mulempyo/ros_robot/gmapping rqt_graph.png

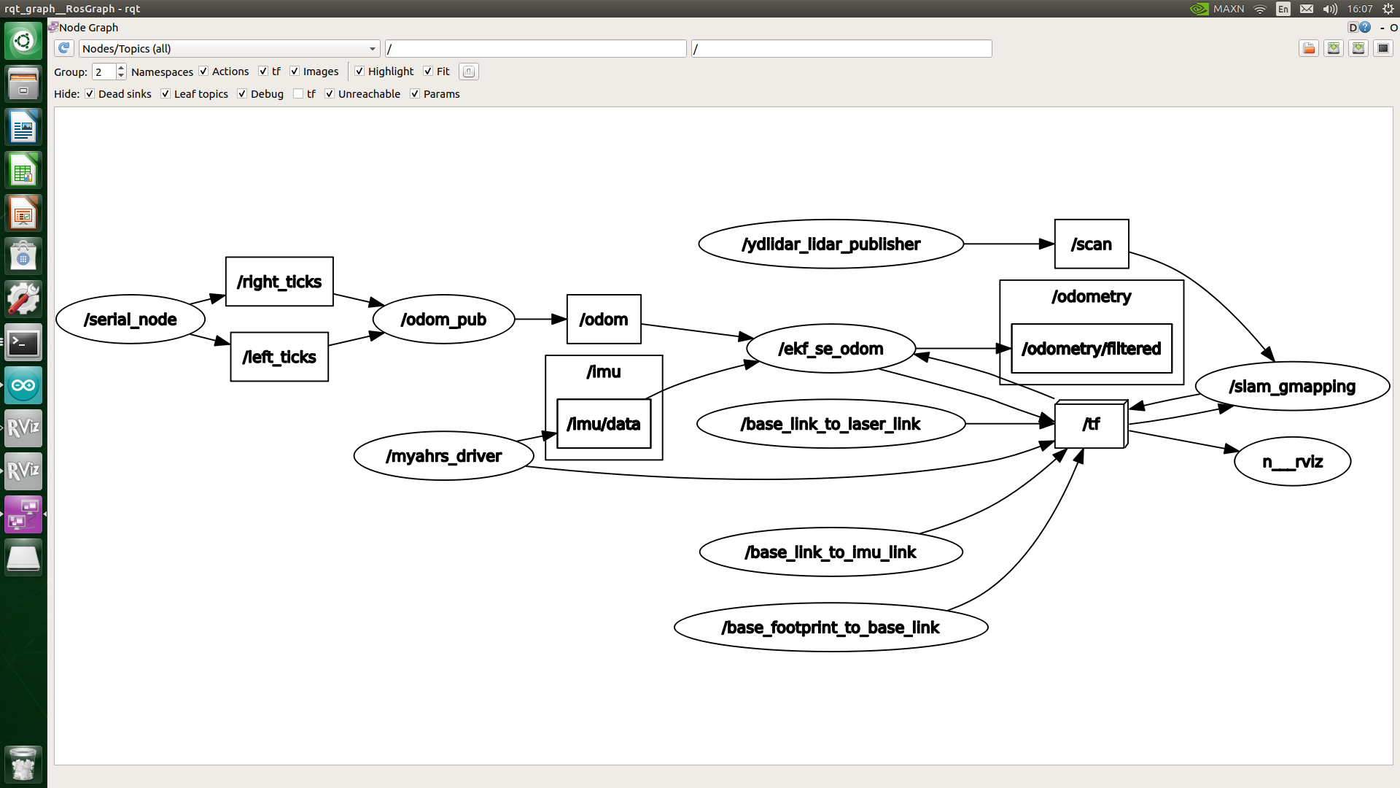
gmapping rqt_graph.png
