mulempyo/ros_robot/gmapping TF.png

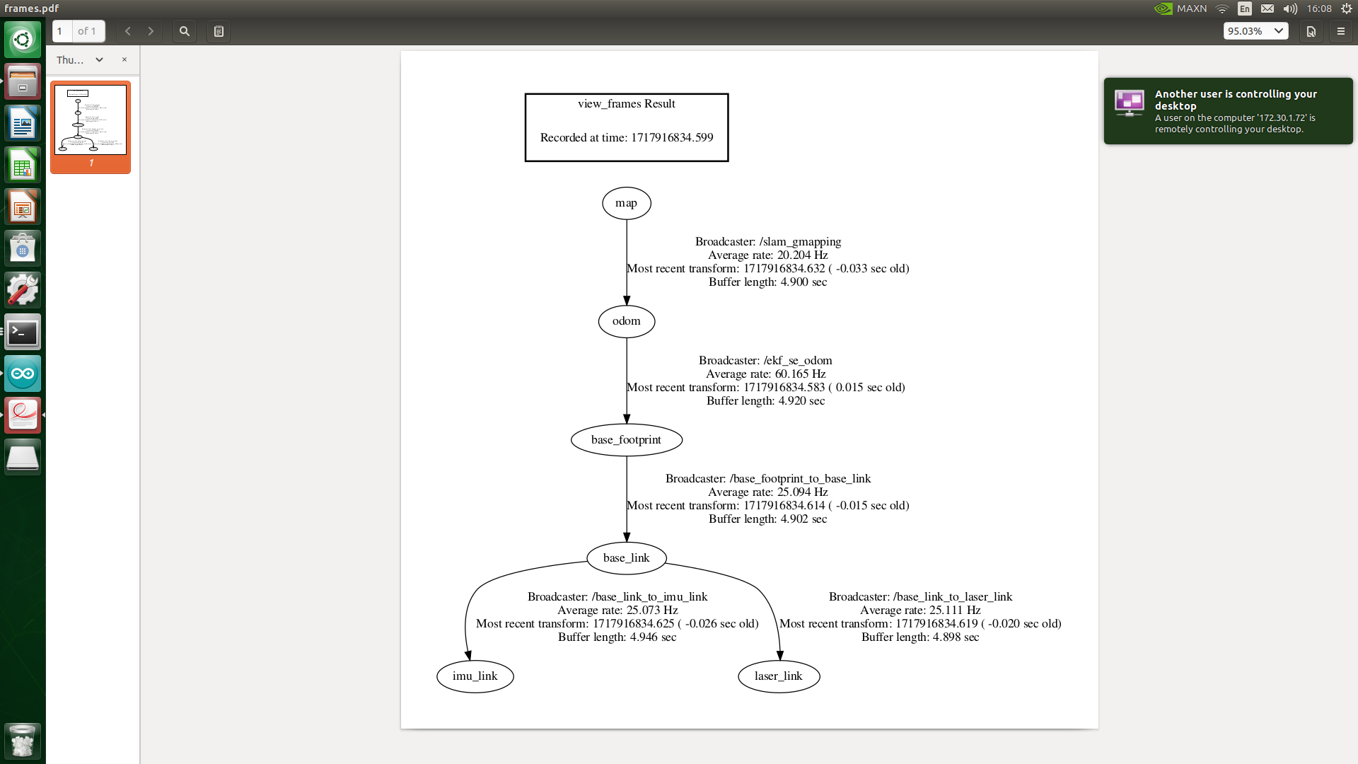
gmapping TF.png
