mulempyo/ros_robot/kwj_description/map/map.png

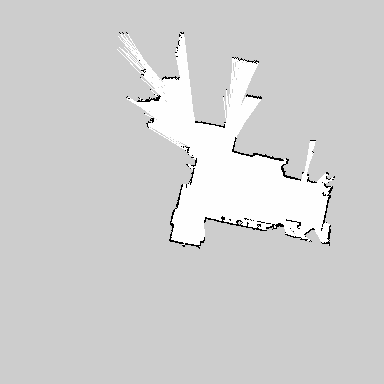
kwj_description/map/map.png
