mulempyo/ros_robot/Navi rqt_graph.png

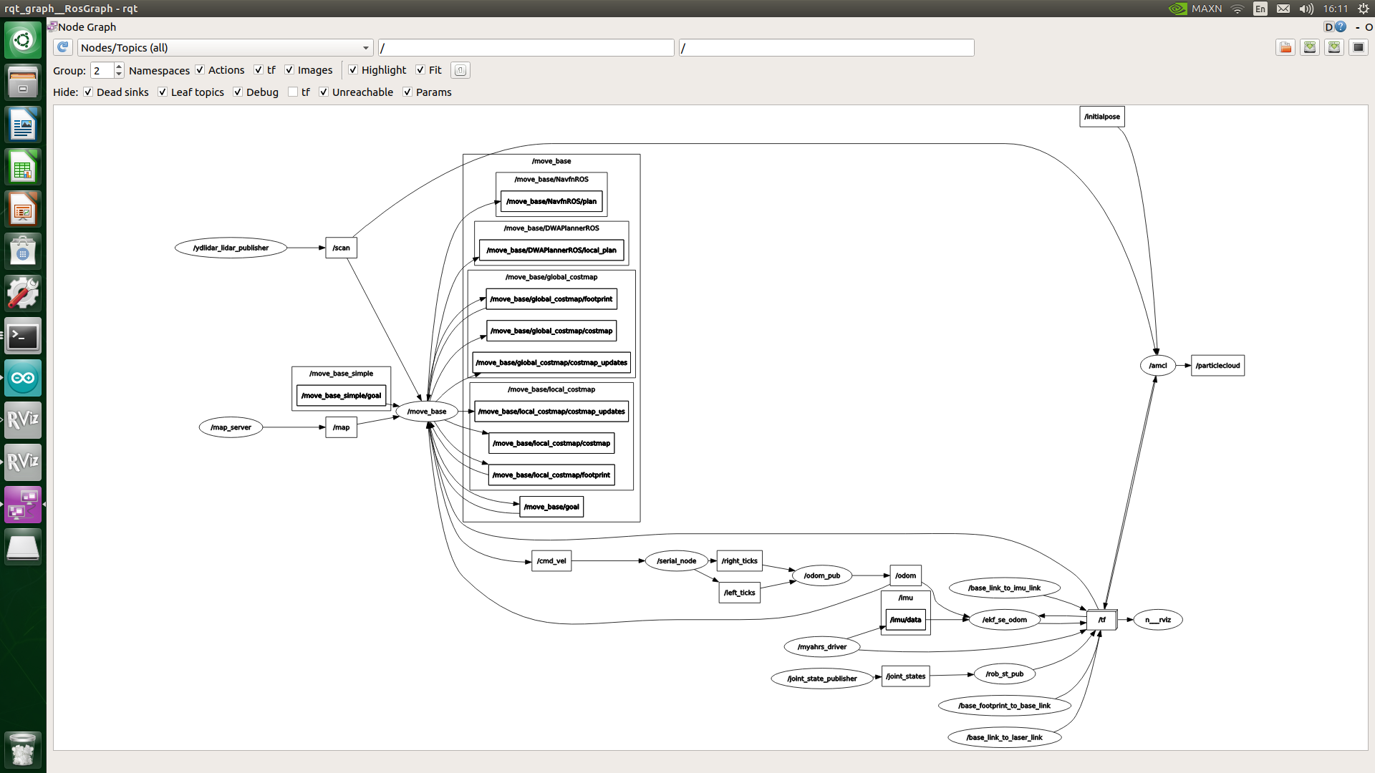
Navi rqt_graph.png
