mulempyo/ros_robot/kwj_description/meshes/new_total_180.stl

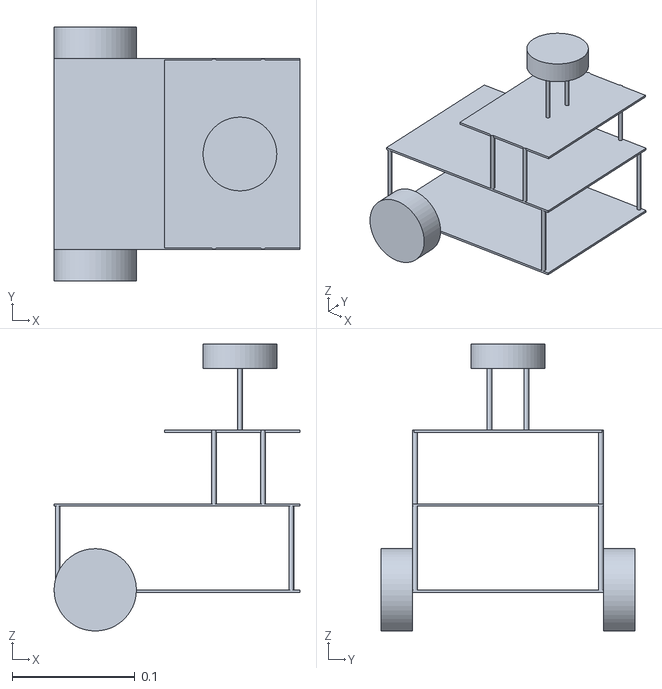
[picture p10: CAD file, 2024-08-14]
kwj_description/meshes/new_total_180.stl
0.2 x 0.207 x 0.234
