mulempyo/ros_robot/kwj_description/meshes/total_180.stl

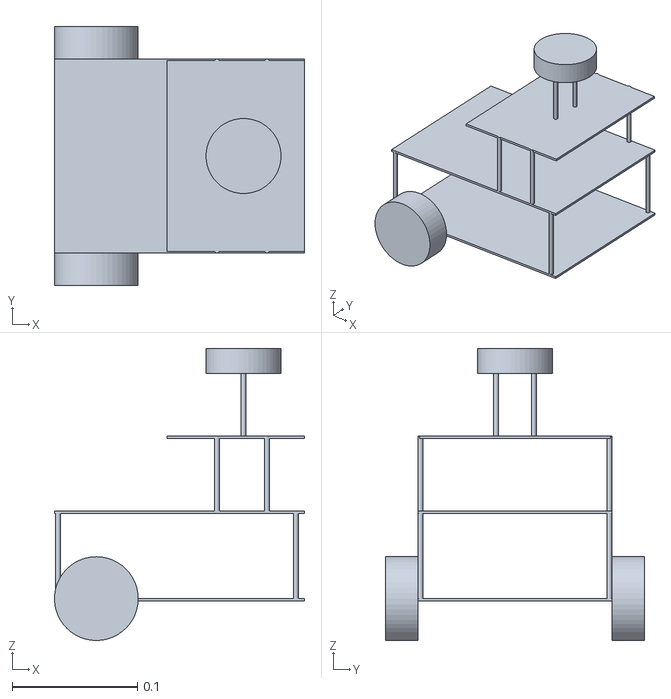
[picture p11: CAD file, 2024-06-15]
kwj_description/meshes/total_180.stl
0.2 x 0.207 x 0.234
