mulempyo/ros_robot/kwj_description/meshes/total.stl

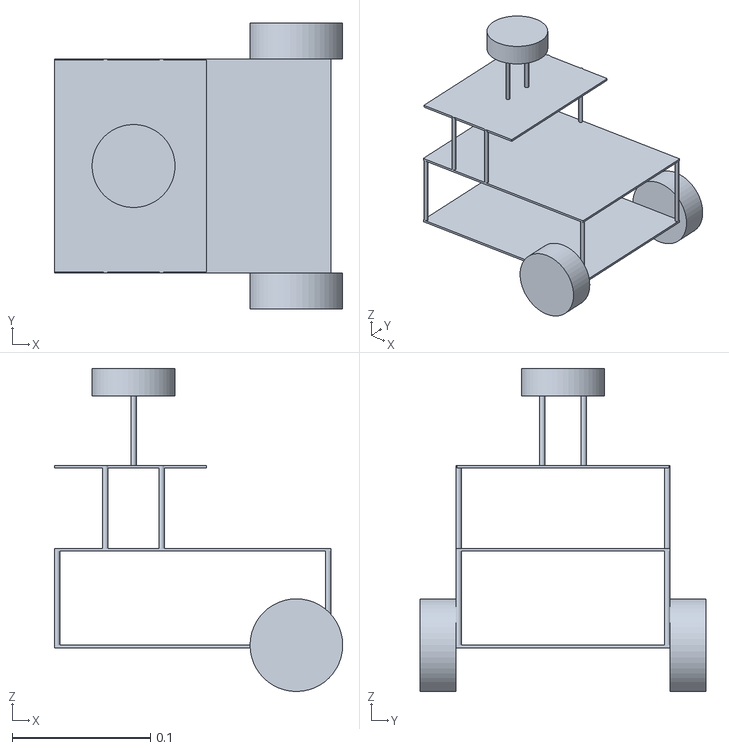
[picture p12: CAD file, 2024-04-25]
kwj_description/meshes/total.stl
0.209 x 0.207 x 0.234
