mulempyo/ros_robot/1층.stl

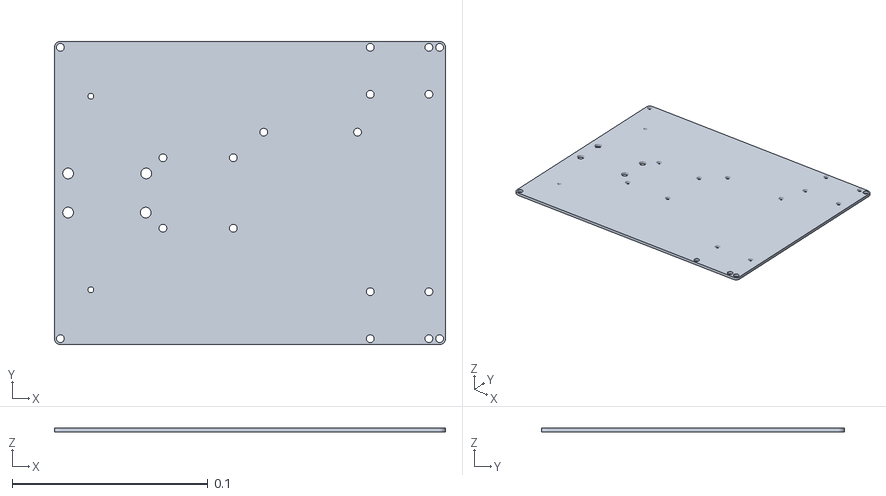
[picture p13: CAD file, 2024-03-20]
1층.stl
0.2 x 0.155 x 0.002
