mulempyo/ros_robot/kwj_description/meshes/urdf_lidar.stl

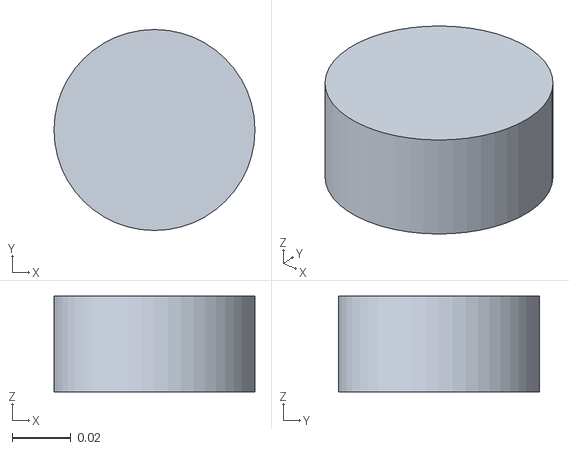
[picture p14: CAD file, 2024-09-23]
kwj_description/meshes/urdf_lidar.stl
0.0687 x 0.0687 x 0.0327
