mulempyo/ros_robot/kwj_description/meshes/base_link.stl

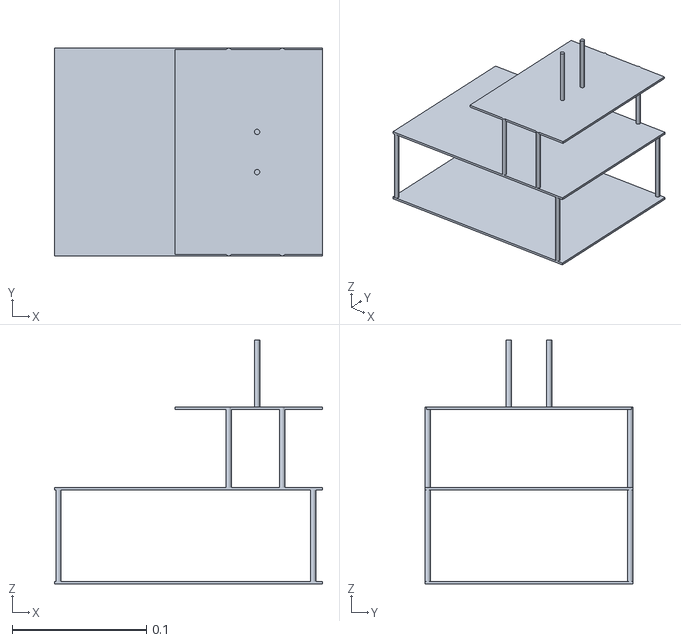
[picture p15: CAD file, 2024-09-23]
kwj_description/meshes/base_link.stl
0.2 x 0.155 x 0.182
