mulempyo/ros_robot/kwj_description/meshes/right_wheel.stl

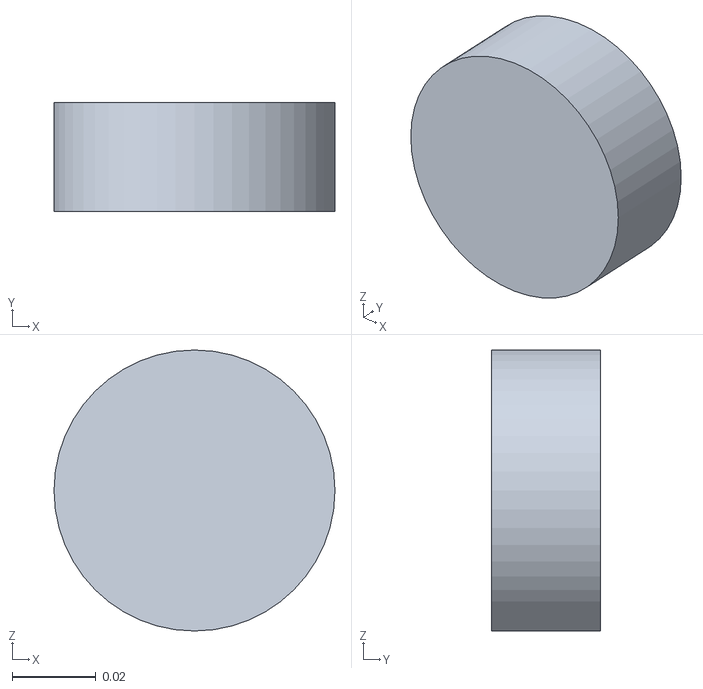
[picture p16: CAD file, 2024-09-23]
kwj_description/meshes/right_wheel.stl
0.067 x 0.026 x 0.067
