mulempyo/ros_robot/Lidar Pro.stl

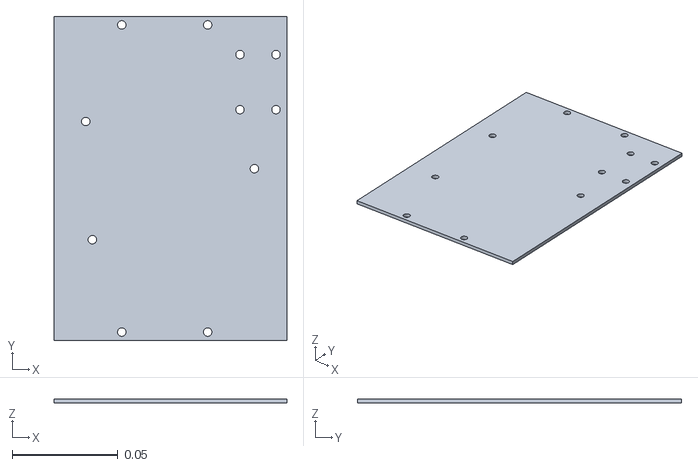
[picture p17: CAD file, 2024-03-20]
Lidar Pro.stl
0.11 x 0.153 x 0.002
