mulempyo/ros_robot/(list of files, cad)

Other CAD files:
2층.stl
kwj_description/meshes/left_wheel.stl
