mulempyo/ros_robot/arduino/encoder_test/encoder_test.ino

/*
this code is just encoder test code
the purpose of this code is to check TICKS_PER_REVOLUTION 

*/


#define ENC_IN_RIGHT_A 2

volatile long right_wheel_pulse_count = 0;

 
void setup() {
  // Open the serial port at 9600 bps
  Serial.begin(9600); 
 
  // Set pin states of the encoder
  pinMode(ENC_IN_RIGHT_A , INPUT_PULLUP);
 
 
  // Every time the pin goes high, this is a pulse
  attachInterrupt(digitalPinToInterrupt(ENC_IN_RIGHT_A), right_wheel_pulse, RISING);
  
}
 
void loop() {
    Serial.print(" Pulses: ");
    Serial.println(right_wheel_pulse_count); 
    
}
 
// Increment the number of pulses by 1
void right_wheel_pulse() {
  right_wheel_pulse_count++;
}
