mulempyo/ros_robot/(commit log)

2023-12-24 change jetson nano
    [urdf.urdf]
2024-01-17 teleop complete with pid, DRIFT_MULTIPLIER
    [PID_publich_ticks_teleop.ino, encoder_test.ino]
2024-01-23 change motor and new pid
2024-02-16 change arduino code
2024-02-29 change battery holder use 18650 lithium battery add path_plan code
2024-03-08 low memory arduino and error local_path_planner.cpp
    [navigation.ino]
2024-03-09 add local_planner and obstacle avoidance
    [navigation.ino]
2024-05-03 success navigation 5 times continuously
    [kwj.xacro, urdf.urdf]
2024-05-12 add angular pid
2024-05-15 change navigation,teleop,urdf code
    [urdf.urdf]
2024-05-16 change navi,teleop code
    [kwj.xacro, total.stl]
2024-05-18 odometry error
    [urdf.urdf]
2024-06-02 need odometry compensation
    [urdf.urdf]
2024-06-04 success navigation and odometry
2024-06-12 add OOP teleop_twist_keyboard motor control arduino
2024-06-17 add OOP navigation arduino code
    [total_180.stl, urdf.urdf]
2024-08-14 add gazebo
    [kwj.gazebo.xacro, kwj.urdf.xacro, new_total_180.stl, total.stl, total_180.stl, urdf.urdf]
2024-08-18 gazebo complete
    [kwj.urdf.xacro]
